PE1PWR/SWR_ESP32_ads1115_ILI9341/Lineair_with_SWR_Project-1.jpg

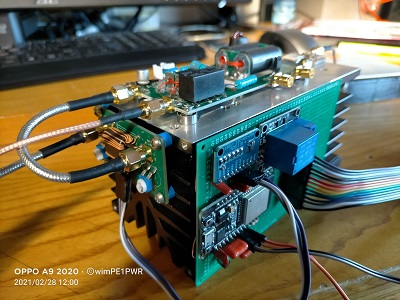
Lineair_with_SWR_Project-1.jpg
