PE1PWR/SWR_ESP32_ads1115_ILI9341/SWR brug.jpg

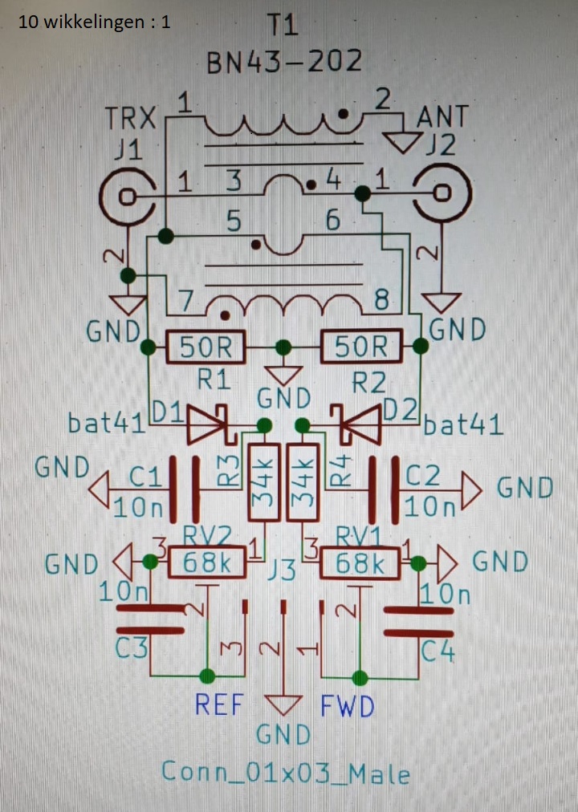
SWR brug.jpg
