PE1PWR/SWR_ESP32_ads1115_ILI9341/README.md

Again made a major change (16-4-2026). Latest version is V17 with new eSPI driver for a better display.
Some pin's are changed for the standard club PCB ESP32 board. Also on Version V17 you dont need tot load SWR_ILI9341.h any more.
Change User_Setup_Select within TFT-ESPI libary and select the correct display. 
After that change Setup1_ILI9341 in the same TFT-eSPI libary for your own pin connecties you need.

Latest version V16 (2026-2-1) is made for IDE 2.3.8.(is based on ADAfruit). Program is slow. 
Older versions V12 and V15 only works on IDE 1.8. X and lower.

Adafruit has made some changes for IDE 2.3.8. 
Normal you can use Adafruit_ADS1115 ads (0X48) ; // AD converter module address.
This wont work anymore. You have to change for a older version within IDE 2.3.8 to this
Adafruit_ADS1115 ads; 

(0X48) is not necessary anymore. 

# SWR_ESP32_ads1115_ILI9341
The script is written for a TFT 3.2 320 X 240 screen. If you are going to use a smaller screen, the image will not be automatically adjusted. It is intended that this is possible in the new version.

There are plans to use the ESP32 to control the SWR and protect the output stage. 100 watts is the maximum power for this SWR version. A higher power is possible if you adjust the calculation and set the scale X100. Also make sure that the input voltage at the ADS1115 does not exceed 5 volts. In that situation, use 2 resistors to divide the voltage.

The touch will be used to adjust the scale true a setup menu for more than 100 watts. The reason that an ADS1115 (16 bits) was used as an AD converter is because the ESP32 AD converter had too small a range that is linear. 800 to 2200 mv (12 bits). Up to 150mv and after 2200mv it is done with linearity. It also emerged that the AD of the ESP32 is very unstable. An extra capacitor used to separate HF from the DC voltage did not work. That ADS1115 is stable is shown by the fact that no capacitor is placed at the input. They ADS1115 is quite linear over a wide range. This is what you see in the value of calculations and the effect on the display. It is very stable.

The formula used for the SWR calculation VSWR = 1+ (Pref / Pfwd) / 1− (Pref / Pfwd) In the programming you can adjust the scale yourself and calibrate it if necessary.

Note the design has been tested with USB 5 volts. In practice this will be around 4.5V. If you want to use a battery of 3.7 volts, put in a converter to 5 volts. If the values expire after using a 5v module, you can adjust them yourself in the code. Will perform a test itself to check progress. If this is the case, I will enter 2 codes one for USB 5v and one for a battery with 5 volt module. And now there is allready another version with protecion relay. Its V12 version. More info see script.

The ESP version V12 has now been expanded with additional security.
As soon as the SWR rises above 1: 3, a relay will ensure that the linear is turned off.
It is then only possible to unlock the protection when the SWR drops below 1: 3 again.
A red LED will signal that the security has come in and that the SWR is not good

Release V14 is a small adjustment to make the display not start earlier when the background is finished with all settings.
This takes about 3 seconds.

Release V14.1 is a small adjustment to show version details before starting.
Release V15 is a small adjustment. The color are changed. Green is ends by swr 1:2 and orange is between 2 and 3. Also digital is now with "SWR a 1:"
