PE1PWR/SWR_ESP32_ads1115_ILI9341/Photo_SWR_Display.jpg

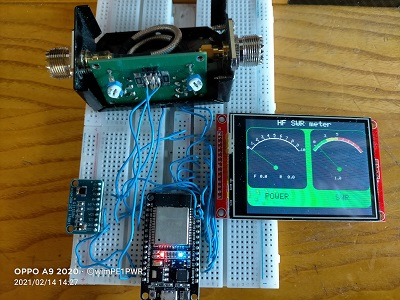
Photo_SWR_Display.jpg
