PE1PWR/SWR_ESP32_ads1115_ILI9341/Schema_ESP32_ILI9341-V3.06.jpg

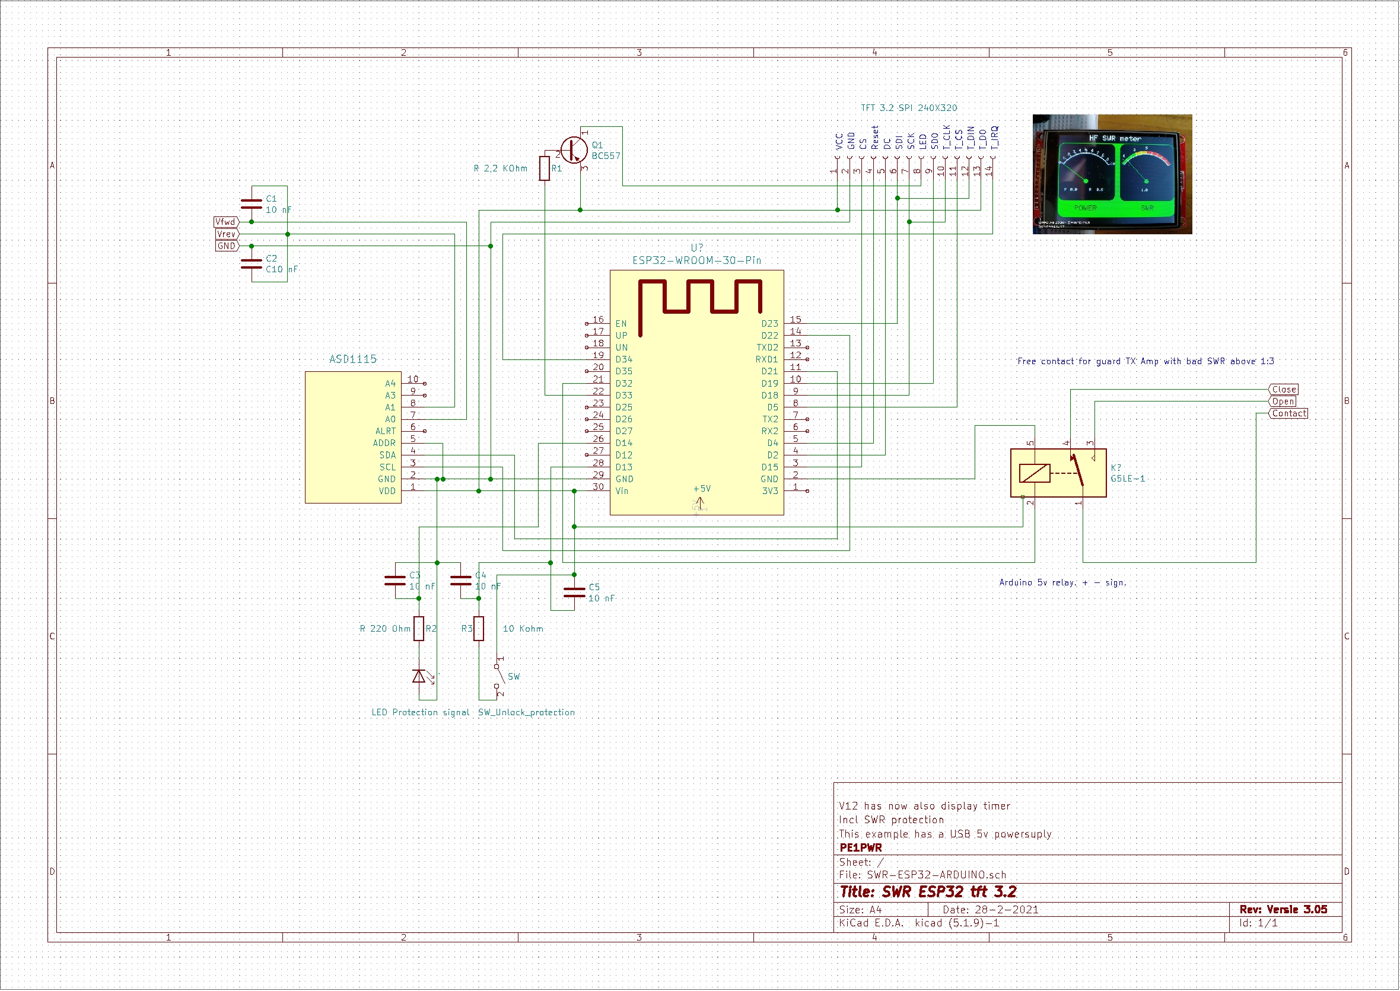
Schema_ESP32_ILI9341-V3.06.jpg
