PE1PWR/SWR_ESP32_ads1115_ILI9341/SWR-ESP32-ARDUINO-V3.03.jpg

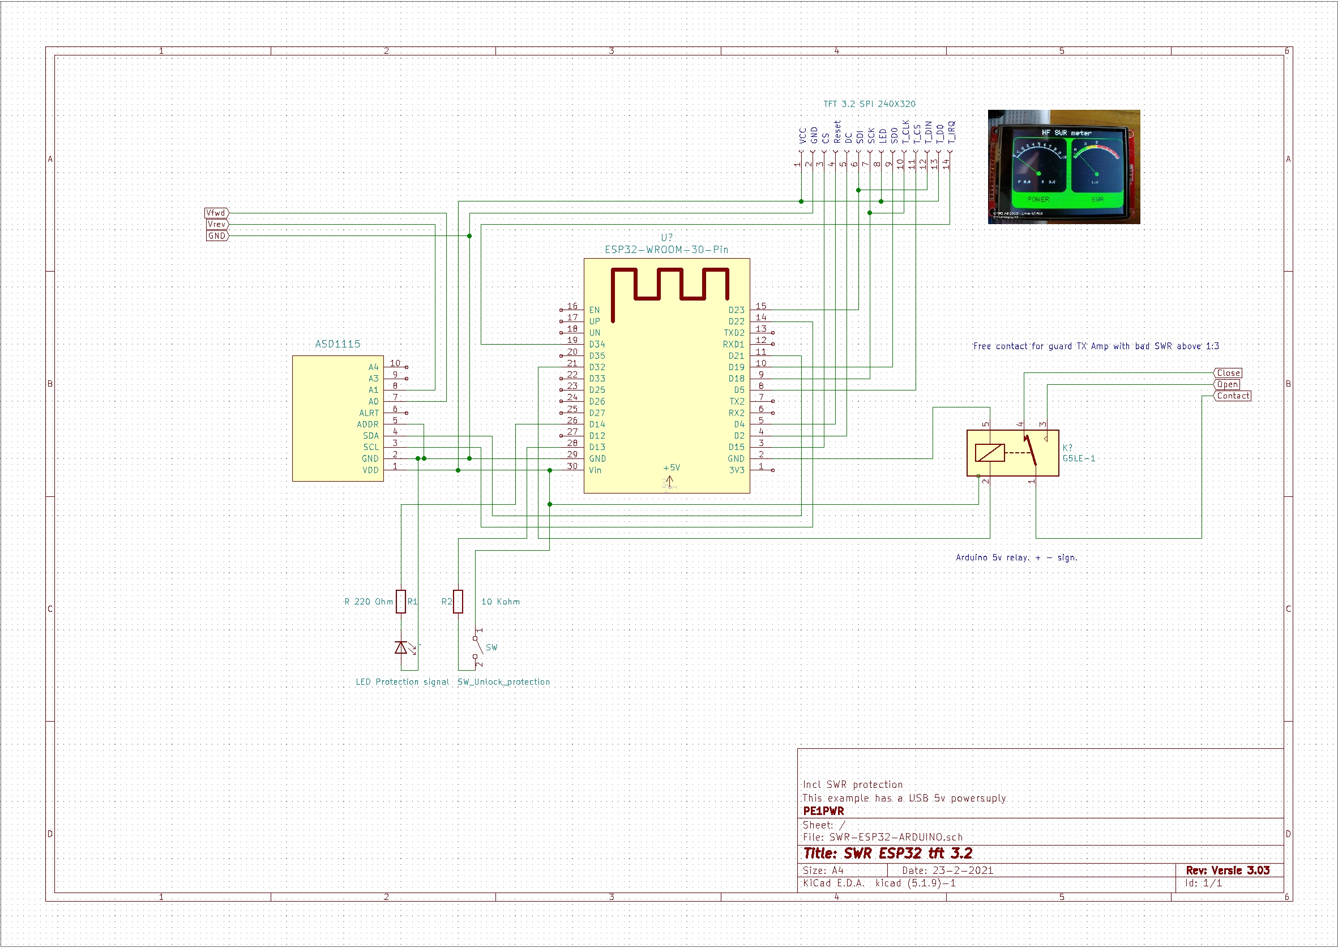
SWR-ESP32-ARDUINO-V3.03.jpg
