PE1PWR/SWR_ESP32_ads1115_ILI9341/(threads)

Thread 1 (2022-12-24):

Thanks

robouden, 2022-12-24:
Wim,

Thanks for the sharing of the project. The information is very useful for me for a project I am working with a friend who wants to build plasma speakers here in Japan. I am very interested in the SWR measurement to get peak performant of RF amplifiers at 27MHz.

I will study what you did and see how I can implement it in the plasma speaker design and report back.

P.S From the write-up and the data of the project, I could imagine you are also Dutch?

Warm regards,
Rob Oudendijk

PE1PWR, 2022-12-24:
Hi Rob,
Inderdaad ook Nederlands
Dank voor je compliment.
Als je vragen hebt hoor ik het wel van je.
Ik heb het project gemaakt voor een zelfbouw lineair. Hij kan meer aangeven dan 100 watt. De naald staat dan voluit maar de digitale info loopt door.
Fijne dagen gewenst.
De PE1PWR,73
Wim Schilperoort

⁣BlueMail voor Android downloaden

Op 24 dec. 2022 09:01, om 09:01, Rob Oudendijk ***@***.***> schreef:
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

robouden, 2022-12-24:
Hoi Wim,

bedankt voor je antwoorden. Ik laat het je wel weten.
Heb net de Frankenmeter gevonden met een soortgelijke swr omzetter.

[https://antrak.org.tr/projeler/frankenmeter-a-simple-qrp-power-swr-meter/](https://antrak.org.tr/projeler/frankenmeter-a-simple-qrp-power-swr-meter/)

Jij ook fijne feestdagen.
Rob

robouden, 2023-01-18:
Win,

The BN43 cores came in yesterday and I will start building the SWR part of the project soon.
I will keep you posted.

Regards,
rob

PE1PWR, 2023-01-18:
That's nice Rob.
Can't wait to se the results.
Wim

⁣BlueMail voor Android downloaden

Op 18 jan. 2023 12:53, om 12:53, Rob Oudendijk ***@***.***> schreef:
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

robouden, 2023-01-19:
BTW.. Did you make a board for the project in KiCad and can share it with me to avoid layout mistakes.?

Regards,
Rob

PE1PWR, 2023-01-19:
No Rob.
I have made it once for my own amplifier project.
Regards
Wim

⁣BlueMail voor Android downloaden

Op 19 jan. 2023 03:11, om 03:11, Rob Oudendijk ***@***.***> schreef:
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
