PE1PWR/SWR_ESP32_ads1115_ILI9341/SWR_color.h

  /// Bouw rood gedeelte op SWR meter 
   
 

    tft.fillScreen(ILI9341_BLACK); // Clear display.
    tft.setTextColor(ILI9341_WHITE);
    tft.setCursor(0,0);                                     
    tft.setTextSize(1);                                    
    tft.print("            HF SWR meter made by PE1PWR"); 
    delay(1000);
    tft.setCursor(0,60);                                     // Put cursur left on screen above.
    tft.setTextSize(1); 
    tft.print("            Sofware version V14.1  2021");
    delay(2000);  
    digitalWrite(LEDDisp, HIGH);        
    tft.fillScreen(ILI9341_BLACK); // Clear display.
    tft.setCursor(0,0);                                     // Put cursur left on screen above.
    tft.setTextSize(2);                                     // text size to normal for the ILI9341
    tft.print("       HF SWR meter");                       // Display title
    tft.drawCircle(x,y,5, ILI9341_GREEN);                   // Draw circle within the center meterA
    tft.drawRoundRect(2,22, 318, 200, 15, ILI9341_GREEN);   // Draw line arround outside meters.
    tft.fillRoundRect(2,22, 318, 200, 15, ILI9341_GREEN);   // Fill everything green in to the circle.
    tft.fillRoundRect(2,22, x+78,y+32, 15, ILI9341_BLACK);  // Build black background meterA.
    tft.fillRoundRect(167,22,x+78,y+33, 15, ILI9341_BLACK); // Build black background meterB.
    tft.drawRoundRect(2,22, x+78,y+32, 15, ILI9341_GREEN);  // Build outside green meterA.
    tft.drawRoundRect(167,22,x+78,y+33, 15, ILI9341_GREEN); // Build outside green meterB.
    tft.setCursor (x-28,y+65) ;   
    tft.setTextColor(ILI9341_BLACK);
    tft.print("POWER");         // Put POWER text within green
    tft.setCursor (a-14,b+65);
    tft.print("SWR");           // Put SWR text within green
    tft.setTextSize(1);
    tft.setCursor(a-2,b-95);
    tft.setTextColor(ILI9341_WHITE);
    tft.print("5");             // Scale indication SWR 
    tft.setCursor(a-35,b-90);
    tft.setTextColor(ILI9341_WHITE);
    tft.print("3");             // Scale indication SWR
    tft.setCursor(a-64,b-73);
    tft.setTextColor(ILI9341_WHITE);
    tft.print("1");             // Schaal indicatie SWR
    tft.drawTriangle(241, 42, 241, 50, 255, 43, ILI9341_RED);  // start 1e red block SWR (2 triangles)
    tft.fillTriangle(241, 42, 241, 50, 255, 43, ILI9341_RED);
    tft.drawTriangle(241, 50, 255, 43, 255, 50, ILI9341_RED);
    tft.fillTriangle(241, 50, 255, 43, 255, 50, ILI9341_RED);  // end 1e red block SWR
    tft.drawTriangle(257, 44, 255, 50, 270, 47, ILI9341_RED);  // start 2e red block SWR (2 triangles)
    tft.fillTriangle(257, 44, 255, 50, 270, 47, ILI9341_RED);
    tft.drawTriangle(256, 50, 270, 47, 270, 55, ILI9341_RED);
    tft.fillTriangle(256, 50, 270, 47, 270, 55, ILI9341_RED);  // end 2e red block SWR
    tft.drawTriangle(272, 48, 269, 56, 284, 55, ILI9341_RED);  // start 3e red block SWR (2 triangles)
    tft.fillTriangle(272, 48, 269, 56, 284, 55, ILI9341_RED);
    tft.drawTriangle(270, 56, 284, 55, 282, 60, ILI9341_RED);
    tft.fillTriangle(270, 56, 284, 55, 282, 60, ILI9341_RED);  // end 3e red block SWR
    tft.drawTriangle(284, 55, 281, 61, 297, 64, ILI9341_RED);  // start 4e red block SWR (2 triangles)
    tft.fillTriangle(284, 55, 281, 61, 297, 64, ILI9341_RED);
    tft.drawTriangle(281, 61, 297, 64, 293, 69, ILI9341_RED);
    tft.fillTriangle(281, 61, 297, 64, 293, 69, ILI9341_RED);  // end 4e red block SWR
    tft.drawTriangle(297, 65, 293, 71, 307, 77, ILI9341_RED);  // start 5e red block SWR (2 triangles)
    tft.fillTriangle(297, 65, 293, 71, 307, 77, ILI9341_RED);
    tft.drawTriangle(292, 71, 307, 77, 301, 80, ILI9341_RED);
    tft.fillTriangle(292, 71, 307, 77, 301, 80, ILI9341_RED);  // end 5e red block SWR
    tft.drawTriangle(226, 43, 226, 50, 240, 42, ILI9341_RED);  // start 1e Orange block SWR (2 triangles)
    tft.fillTriangle(226, 43, 226, 50, 240, 42, ILI9341_RED);
    tft.drawTriangle(226, 50, 240, 42, 240, 50, ILI9341_RED);  
    tft.fillTriangle(226, 50, 240, 42, 240, 50, ILI9341_RED);  // end 1e orange block SWR
    tft.drawTriangle(210, 47, 213, 53, 224, 43, ILI9341_RED);  // start 2e Orange block SWR (2 triangles)
    tft.fillTriangle(210, 47, 213, 53, 224, 43, ILI9341_RED);
    tft.drawTriangle(213, 53, 224, 43, 225, 50, ILI9341_RED);  
    tft.fillTriangle(213, 53, 224, 43, 225, 50, ILI9341_RED);  // end 2e orange block SWR
    tft.drawTriangle(197, 53, 199, 59, 210, 47, ILI9341_ORANGE);   // start 1e green block SWR (2 triangles)
    tft.fillTriangle(197, 53, 199, 59, 210, 47, ILI9341_ORANGE);  
    tft.drawTriangle(199, 59, 210, 47, 213, 55, ILI9341_ORANGE);  
    tft.fillTriangle(199, 59, 210, 47, 213, 55, ILI9341_ORANGE);   // end 1e green block SWR
    tft.drawTriangle(185, 63, 187, 68, 196, 54, ILI9341_GREEN);   // start 2e green block SWR (2 triangles
    tft.fillTriangle(185, 63, 187, 68, 196, 54, ILI9341_GREEN);  
    tft.drawTriangle(187, 68, 196, 54, 198, 60, ILI9341_GREEN);  
    tft.fillTriangle(187, 68, 196, 54, 198, 60, ILI9341_GREEN);   // end 2e green block SWR
    tft.drawTriangle(185, 63, 187, 68, 196, 54, ILI9341_GREEN);   // start 3e green block SWR (2 triangles)
    tft.fillTriangle(185, 63, 187, 68, 196, 54, ILI9341_GREEN);  
    tft.drawTriangle(173, 75, 177, 79, 184, 64, ILI9341_GREEN);   
    tft.fillTriangle(173, 75, 177, 79, 184, 64, ILI9341_GREEN);   
    tft.drawTriangle(178, 80, 184, 64, 188, 70, ILI9341_GREEN);  
    tft.fillTriangle(178, 80, 184, 64, 188, 70, ILI9341_GREEN);   // end 3e green block SWR (2 triangles)
